Curious-Utkarsh/Indoor_Service_AMR/mobi_vision/aruco_markers/Marker0.png

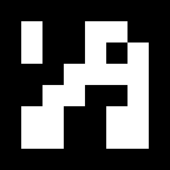
mobi_vision/aruco_markers/Marker0.png
