Curious-Utkarsh/Indoor_Service_AMR/mobi_vision/aruco_markers/Marker1.png

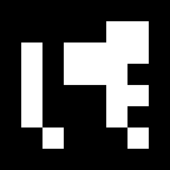
mobi_vision/aruco_markers/Marker1.png
