Curious-Utkarsh/Indoor_Service_AMR/mobi_gui/parts/gui-launcher/src/snap/local/robot-launcher.png

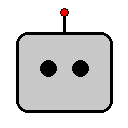
mobi_gui/parts/gui-launcher/src/snap/local/robot-launcher.png
