Curious-Utkarsh/Indoor_Service_AMR/mobi_description/meshes/torso.stl

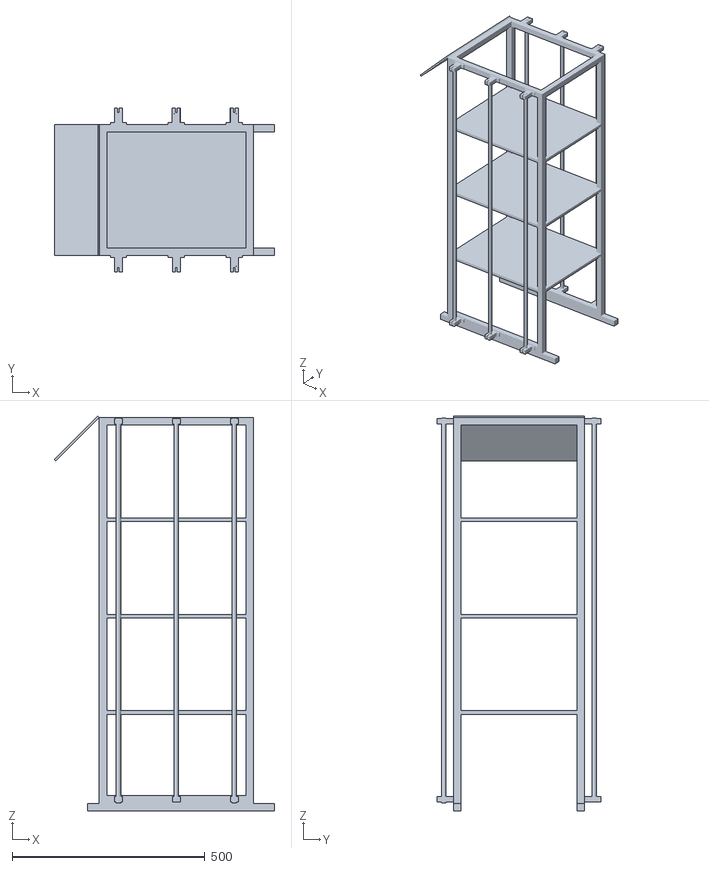
[picture p4: CAD file, 2025-07-23]
mobi_description/meshes/torso.stl
571.3 x 424.0 x 1023.9
