Curious-Utkarsh/Indoor_Service_AMR/mobi_description/meshes/right_castor.stl

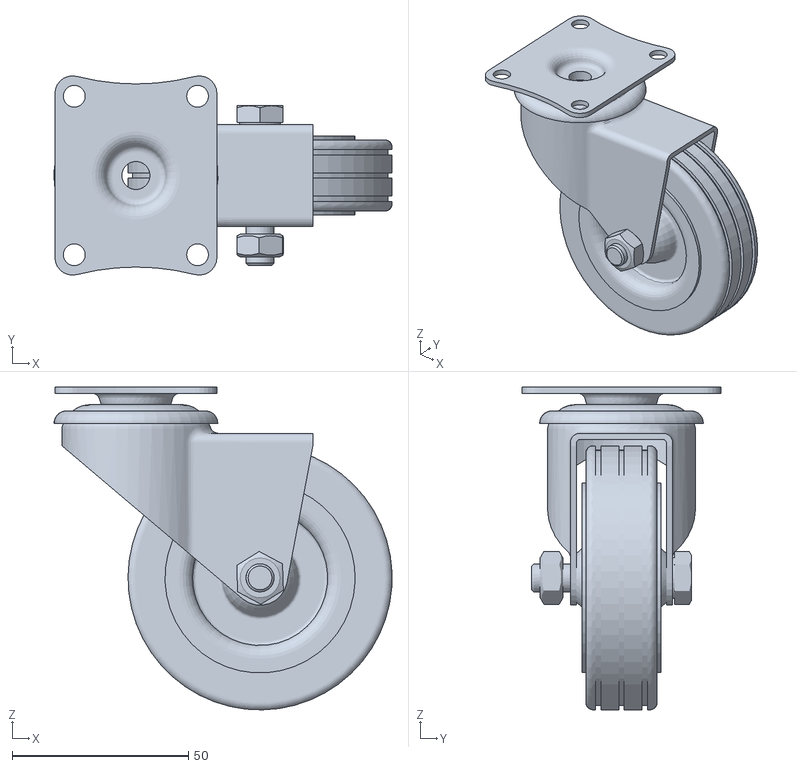
[picture p5: CAD file, 2025-06-25]
mobi_description/meshes/right_castor.stl
96.0 x 56.6 x 91.7
