Curious-Utkarsh/Indoor_Service_AMR/mobi_description/meshes/right_wheel.stl

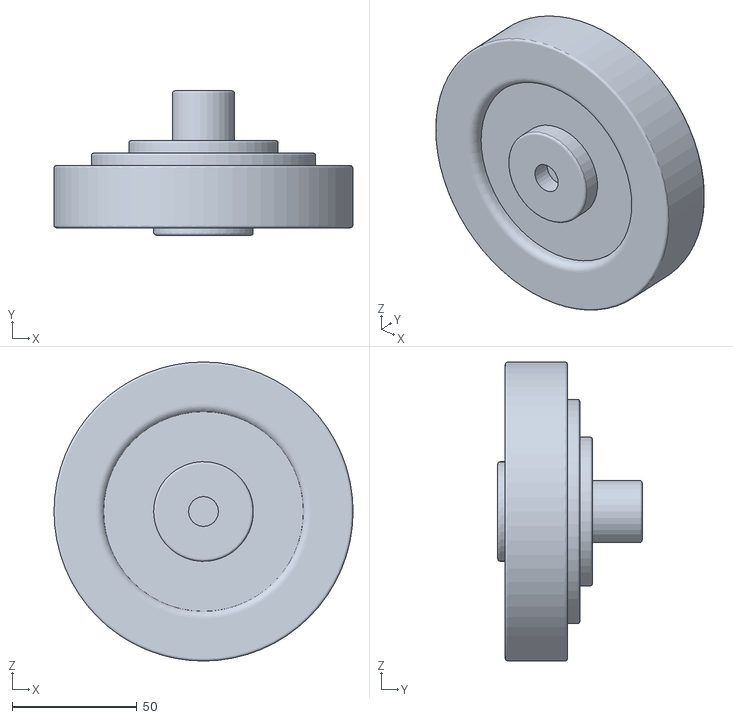
[picture p6: CAD file, 2025-06-25]
mobi_description/meshes/right_wheel.stl
120.0 x 58.0 x 120.0
