Curious-Utkarsh/Indoor_Service_AMR/mobi_description/meshes/base_link.stl

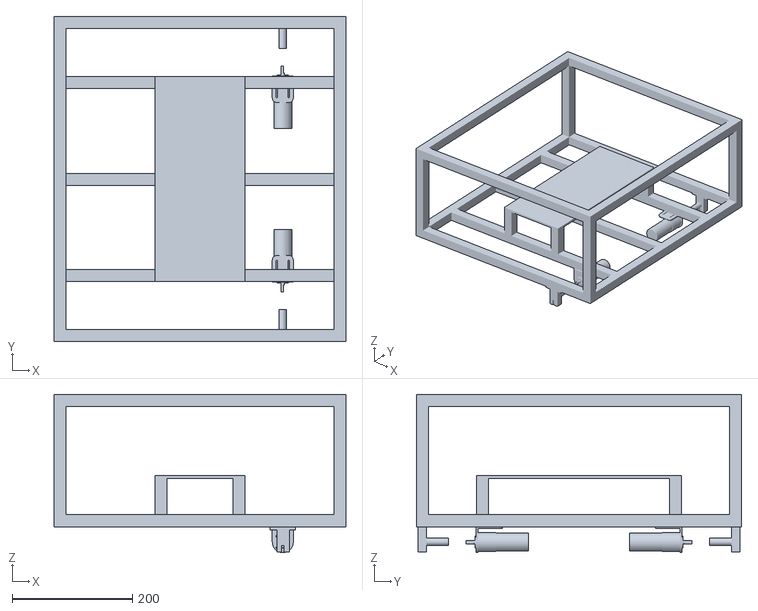
[picture p7: CAD file, 2025-06-25]
mobi_description/meshes/base_link.stl
485.0 x 540.0 x 263.0
