Curious-Utkarsh/Indoor_Service_AMR/mobi_description/meshes/ultrasonic.stl

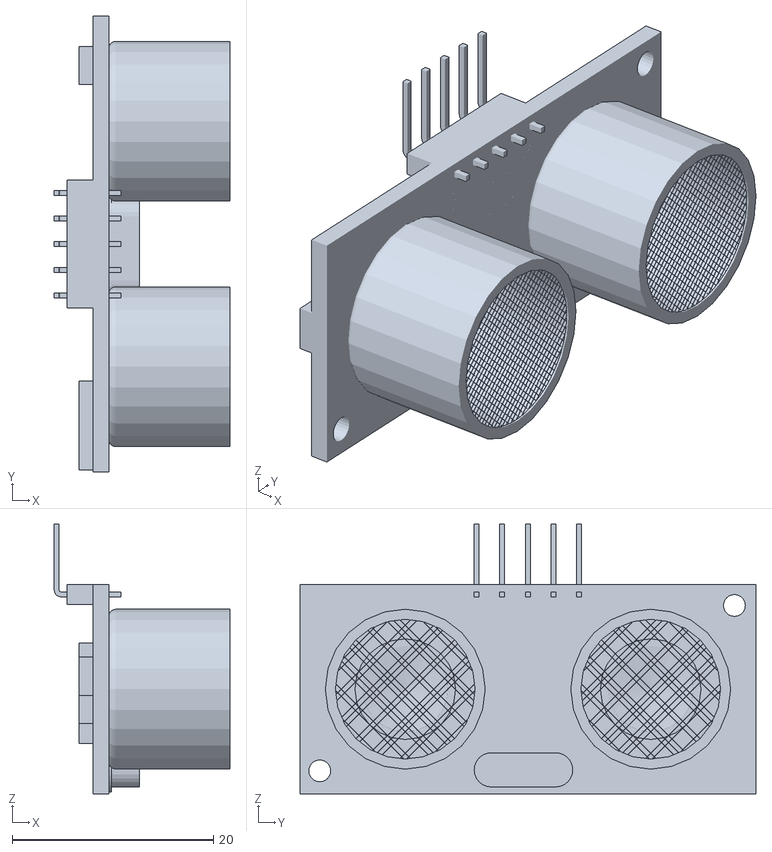
[picture p8: CAD file, 2025-06-09]
mobi_description/meshes/ultrasonic.stl
17.5 x 45.3 x 26.8
