Curious-Utkarsh/Indoor_Service_AMR/mobi_description/meshes/lidar.stl

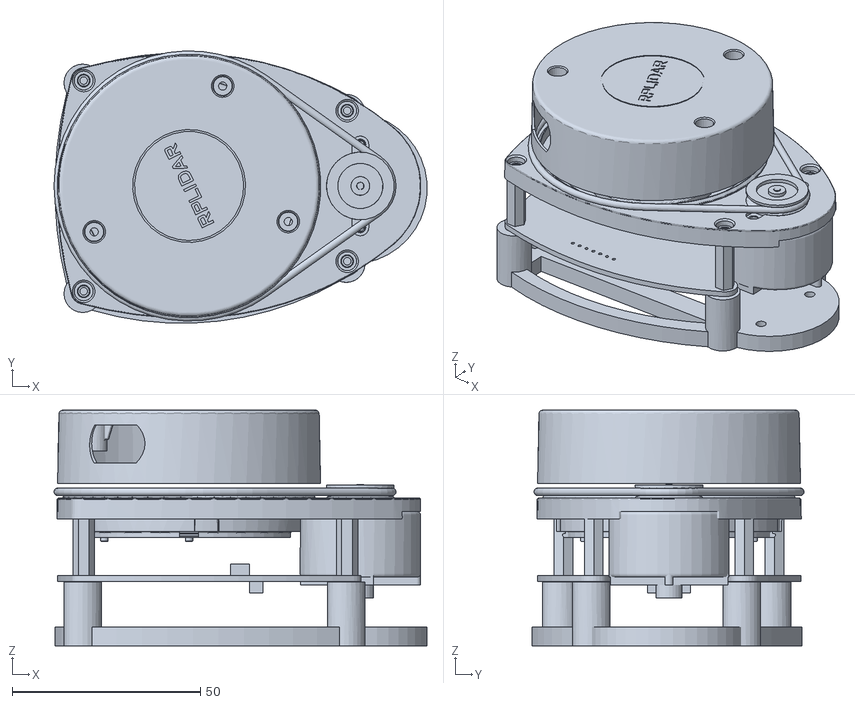
[picture p9: CAD file, 2025-06-09]
mobi_description/meshes/lidar.stl
99.1 x 72.3 x 62.6
