Curious-Utkarsh/Indoor_Service_AMR/mobi_description/meshes/camera.stl

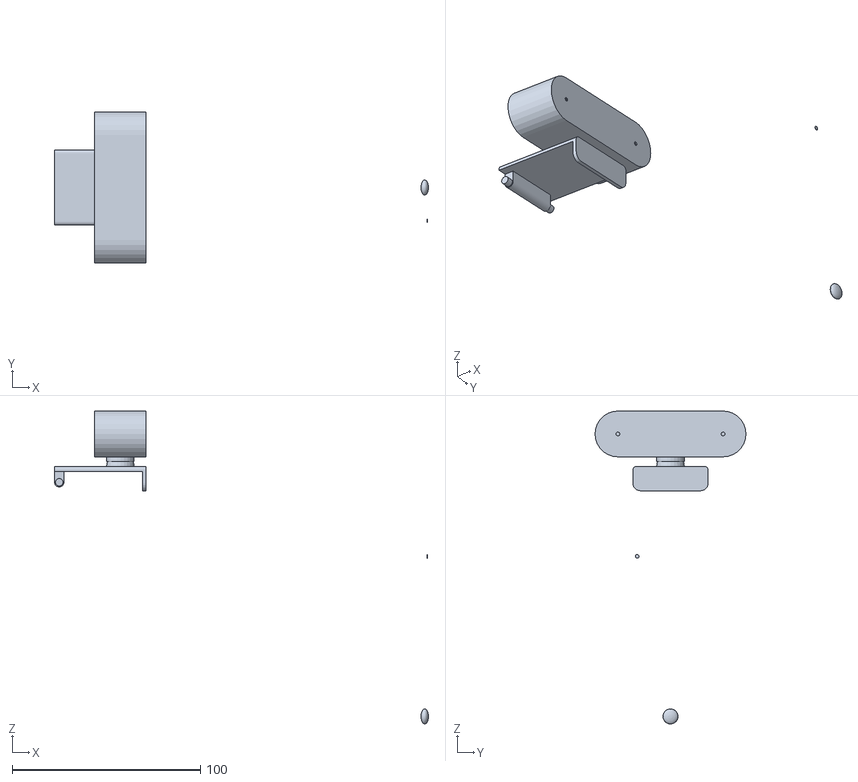
[picture p10: CAD file, 2025-04-16]
mobi_description/meshes/camera.stl
198.6 x 80.2 x 166.2
