Curious-Utkarsh/Indoor_Service_AMR/mobi_description/meshes/guide_rail.stl

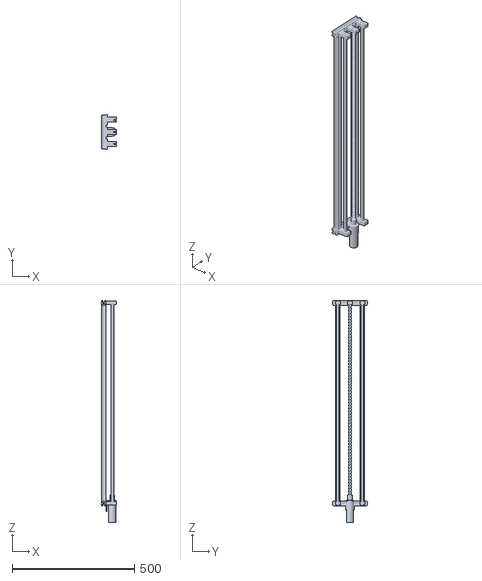
[picture p11: CAD file, 2025-04-16]
mobi_description/meshes/guide_rail.stl
62.9 x 142.0 x 908.0
