Curious-Utkarsh/Indoor_Service_AMR/mobi_description/meshes/neck_y.stl

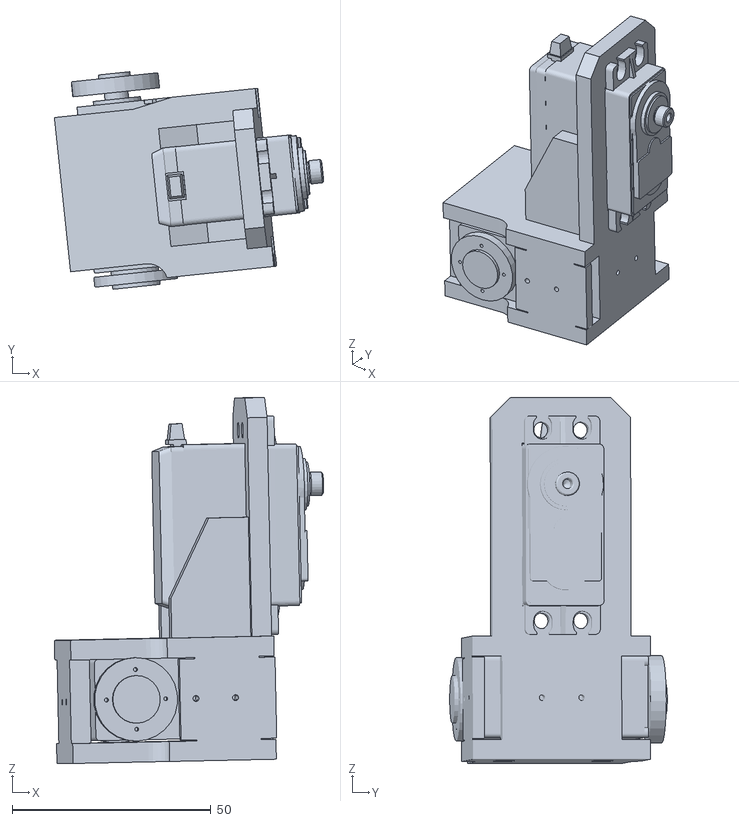
[picture p12: CAD file, 2025-04-16]
mobi_description/meshes/neck_y.stl
67.7 x 54.7 x 92.1
