Curious-Utkarsh/Indoor_Service_AMR/mobi_description/meshes/neck_z.stl

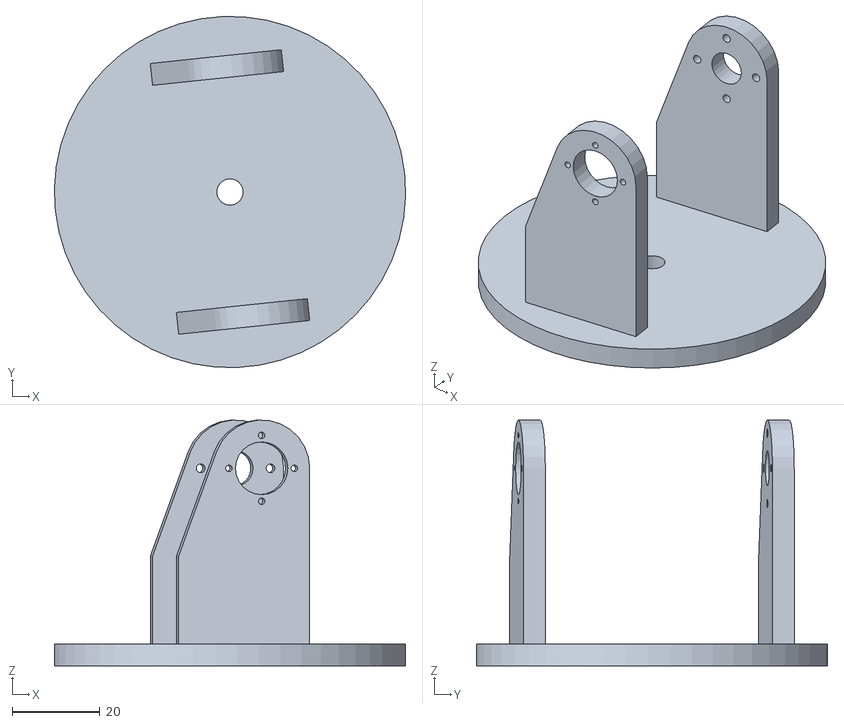
[picture p13: CAD file, 2025-04-16]
mobi_description/meshes/neck_z.stl
80.0 x 79.9 x 56.0
