Curious-Utkarsh/Indoor_Service_AMR/mobi_description/meshes/upper_body.stl

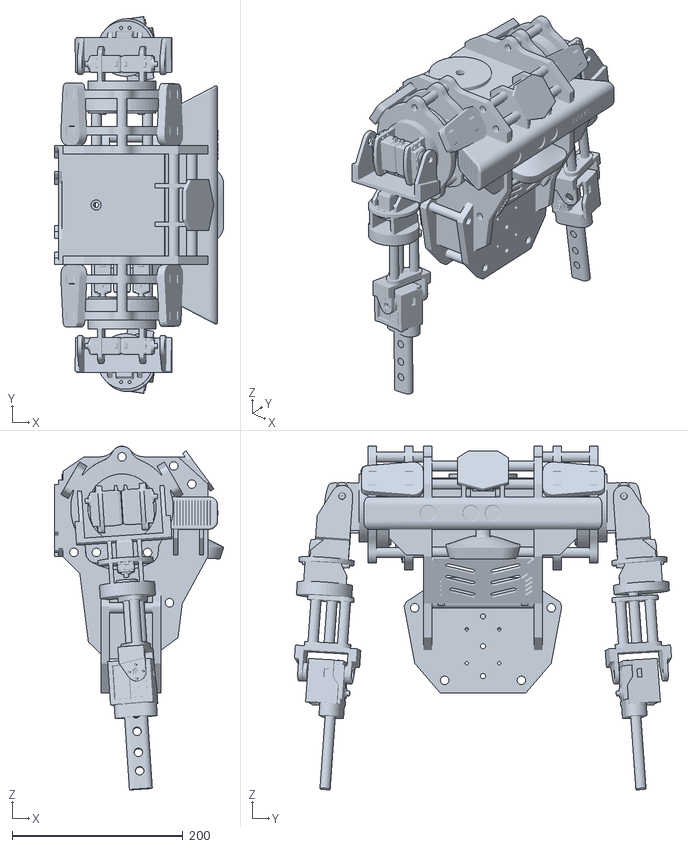
[picture p14: CAD file, 2025-04-16]
mobi_description/meshes/upper_body.stl
198.6 x 441.7 x 402.7
