Curious-Utkarsh/Indoor_Service_AMR/mobi_description/meshes/head.stl

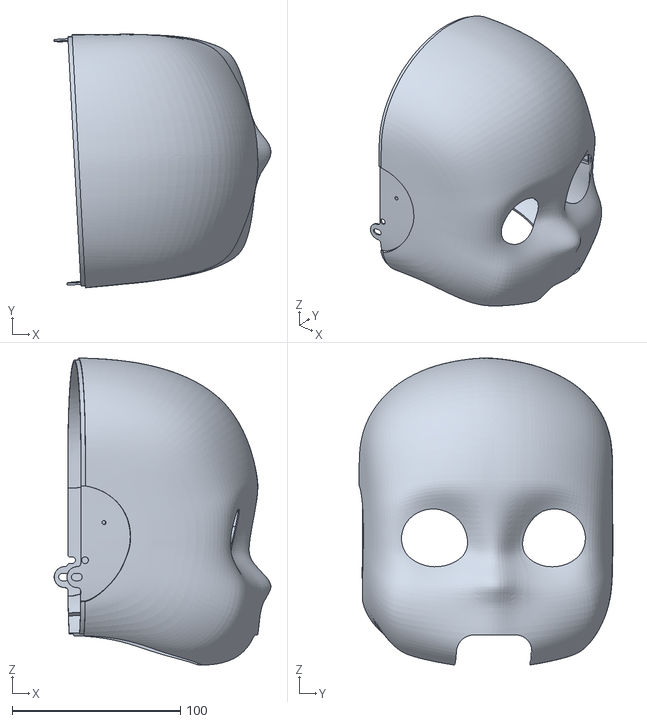
[picture p15: CAD file, 2025-04-16]
mobi_description/meshes/head.stl
128.8 x 150.7 x 182.4
