Curious-Utkarsh/Indoor_Service_AMR/(list of files, cad)

Other CAD files:
mobi_description/meshes/left_castor.stl
mobi_description/meshes/left_wheel.stl
mobi_description/meshes/front_castor.stl
mobi_description/meshes/bl_castor.stl
mobi_description/meshes/fl_castor.stl
mobi_description/meshes/fr_castor.stl
mobi_description/meshes/br_castor.stl
