Curious-Utkarsh/Indoor_Service_AMR/mobi_controller/config/mobi_controllers.yaml

controller_manager:
  ros__parameters:
    update_rate: 100 # Hz

    wheel_controller:
      type: diff_drive_controller/DiffDriveController

    # rail_controller:
    #   type: joint_trajectory_controller/JointTrajectoryController

    # neck_controller:
    #   type: joint_trajectory_controller/JointTrajectoryController

    joint_state_broadcaster:
      type: joint_state_broadcaster/JointStateBroadcaster


wheel_controller:
  ros__parameters:
    type: diff_drive_controller/DiffDriveController

    use_stamped_vel: false #To use Twist instead of TwistStamped
    
    left_wheel_names  : ['left_wheel_joint']
    right_wheel_names : ['right_wheel_joint']

    publish_rate: 50.0               # default: 50

    wheel_separation : 0.455
    wheel_radius : 0.06 #Its radius not dia. so r = dia/2 which is 0.12/2 = 0.06

    wheel_separation_multiplier: 1.0
    left_wheel_radius_multiplier: 1.0
    right_wheel_radius_multiplier: 1.0

    # Velocity commands timeout [s], default 0.5
    cmd_vel_timeout: 0.5

    # Base frame_id
    base_frame_id: base_footprint #default: base_link

    # Publish limited velocity
    publish_limited_velocity: true

    # Publish wheel data
    publish_wheel_data: true

    # Publish to TF directly or not
    enable_odom_tf: true

    # Velocity and acceleration limits
    # Whenever a min_* is unspecified, default to -max_*
    linear:
      x:
        has_velocity_limits    : true
        max_velocity           : 0.7  # m/s
        min_velocity           : -0.7 # m/s
        has_acceleration_limits: true
        max_acceleration       : 0.7  # m/s^2
        min_acceleration       : -0.7 # m/s^2
        has_jerk_limits        : false
        max_jerk               : 5.0  # m/s^3
    angular:
      z:
        has_velocity_limits    : true
        max_velocity           : 8.5  # rad/s
        min_velocity           : -8.5  # rad/s
        has_acceleration_limits: true
        max_acceleration       : 5.0  # rad/s^2
        min_acceleration       : -5.0   # rad/s^2
        has_jerk_limits        : false
        max_jerk               : 2.5  # rad/s^3


# rail_controller:
#   ros__parameters:
#     joints:
#       - joint_1

#     command_interfaces:
#       - position

#     state_interfaces:
#       - position

#     open_loop_control: true
#     allow_integration_in_goal_trajectories: true
#     controller_frequency: 10 #It is very import to add or else things wont work for arms and grippers.


# neck_controller:
#   ros__parameters:
#     joints:
#       - joint_2
#       - joint_3

#     command_interfaces:
#       - position

#     state_interfaces:
#       - position

#     open_loop_control: true
#     allow_integration_in_goal_trajectories: true
#     controller_frequency: 10
