Curious-Utkarsh/Indoor_Service_AMR/(commit log)

2025-04-16 Upper Body Urdf Added
2025-06-11 Lidar Bot Obstruction Fixed
2025-06-25 Wheel Position Corrected in URDF and Design
2026-10-20 docs: add face-tracking demo and CAD-to-Gazebo series
    Adds the face/hand tracking head demo and the 4-part Fusion 360 -> URDF -> Gazebo video series to the Demo section.
2026-10-22 README: link the portfolio case study
